Konxas8/Rocket-Motor-Test-Stand/ΒΑΣΗ ΔΟΚΙΜΗΣ ΚΙΝΗΤΗΡΩΝ ΠΥΡΑΥΛΩΝ.pdf

# ΒΑΣΗ ΔΟΚΙΜΗΣ ΚΙΝΗΤΗΡΩΝ ΠΥΡΑΥΛΩΝ

### 1. Εισαγωγή

Το παρόν κύκλωμα ειναι ενα σύστημα στατικής δοκιμής (Test Stand) για πυραυλοκινητήρες. Ο βασικός του σκοπός είναι διπλός:

1. Να πυροδοτήσειτον κινητήρα με ασφάλεια και ακρίβεια από απόσταση.
2. Να μετρήσει και να καταγράψειτηνώση (δύναμη) που παράγει ο κινητήρας σε πραγματικό χρόνο.

### 2. Ανάλυση Υποσυστημάτων

Α. Ο "Εγκέφαλος" (ESP32)

Στο κέντρο του συστήματος βρίσκεται ο μικροελεγκτής ESP32. Αυτός είναι ο υπολογιστής που συντονίζειτα πάντα. Τροφοδοτείται από μια ξεχωριστή μπαταρία LiPo (μέσω Buck Converter) για να παραμένει σταθερός και ανεπηρέαστος από τα μεγάλα ρεύματα της ανάφλεξης.

- Ρόλος: Διαβάζειτους αισθητήρες, αποθηκεύειτα δεδομένα και δίνει την εντολή πυροδότησης.

Β. Μέτρηση Δύναμης (Load Cell & HX711)

Για να μετρήσουμε πόσο δυνατά σπρώχνει ο κινητήρας, χρησιμοποιούμε ένα Load Cell. Το Load Cell μετατρέπει τη μηχανική πίεση σε ένα πολύ μικρό ηλεκτρικό σήμα.

- Επειδή αυτό το σήμα είναι ασθενές, παρεμβάλλεται ο ενισχυτής HX711, ο οποίος το μεταφράζει σε ψηφιακή μορφή ώστε να το διαβάσει το ESP32.

Γ. Σύστημα Ανάφλεξης (Ασφάλεια Δύο Σταδίων)

Για να ανάψει ο κινητήρας, χρησιμοποιούμε μια ισχυρή μπαταρία 12V (Μολύβδου). Το ρεύμα όμως δεν περνάει στον αναφλεκτήρα (Ematch) αν δεν συμφωνήσουν δύο ανεξάρτητα εξαρτήματα:

1. Το Μηχανικό Ρελέ (Relay): Λειτουργείως η "ασφάλεια οπλισμού". Ελέγχεται από ένα φυσικό κλειδί (Key Switch). Όσο το κλειδί είναι κλειστό,το κύκλωμα είναι φυσικά κομμένο. Ακόμα κι αν ο υπολογιστής κάνει λάθος, δεν μπορεί να περάσει ρεύμα. Όταν γυρίσουμε το κλειδί, το σύστημα "Οπλίζει".
2. Το MOSFET: Είναι ο ηλεκτρονικός διακόπτης ταχείας απόκρισης. Ακόμα και με το σύστημα οπλισμένο (Ρελέ κλειστό), το ρεύμα σταματάει στο MOSFET. Μόνο όταν το ESP32 δώσει ψηφιακή εντολή (μέσω λογισμικού),το MOSFET ανοίγει και επιτρέπει στο ρεύμα των 12V να φτάσει στον αναφλεκτήρα.

Δ. Έλεγχος Συνέχειας (Continuity Check)

Πριν την εκτόξευση, θέλουμε να ξέρουμε αν το καλώδιο του αναφλεκτήρα είναι συνδεδεμένο σωστά και δεν έχει κοπεί.

- Το κύκλωμα διαθέτει ένα κουμπί ελέγχου και ένα LED.
- Όταν πατάμε το κουμπί, περνάει ένα ελάχιστο, ασφαλές ρεύμα (περίπου 10mA) μέσα από τον αναφλεκτήρα.
- Αν το LED ανάψει, σημαίνει ότι το κύκλωμα είναι κλειστό και ο αναφλεκτήρας είναι έτοιμος. Το ρεύμα αυτό είναι πολύ μικρό για να προκαλέσει ανάφλεξη, αλλά αρκετό για να ανάψειτο λαμπάκι.

Ε. Καταγραφή Δεδομένων (SD Card+Wifi)

Όλα τα δεδομένα της μέτρησης (χρόνος και δύναμη) γράφονται σε μια κάρτα microSD πολλές φορές το δευτερόλεπτο. Έτσι, μετά τη δοκιμή, μπορούμε να πάρουμε την κάρτα στον υπολογιστή και να αναλύσουμε την καμπύλη ώσης του κινητήρα.

### 3. Διαδικασία Λειτουργίας

1. Εκκίνηση: Τροφοδοτούμε το ESP32. Το σύστημα κάνει αυτοδιαγνωστικό έλεγχο.
2. Τοποθέτηση: Συνδέουμε τον αναφλεκτήρα στον κινητήρα.
3. Eλεγχος: Εαν το continuity led ειναι αναμμενο σημαινει πως το mosfet μας ειναι χαλασμενο.
4. Οπλισμός: Γυρίζουμε το Κλειδί Ασφαλείας. Το Ρελέ οπλίζει. Τώρα το σύστημα περιμένει εντολή.Παταμε το continuity button και αν αναψειτο led ο αναφλεκτυρας μας ειναι συνδεδεμένος σωστά.
5. Πυροδότηση: Το ESP32 δίνει εντολή στο MOSFET. Το MOSFET ανοίγει περνάει υψηλό ρεύμα, ο κινητήρας ανάβει.
6. Καταγραφή: Ταυτόχρονα,το ESP32 καταγράφειτις τιμές από το Load Cell στην κάρτα SD μέχρι να τελειώσει η καύση.

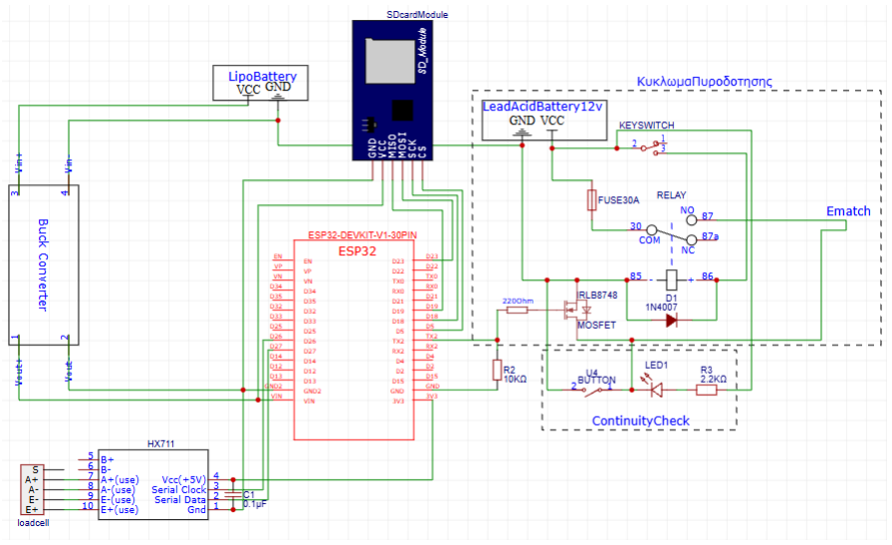
[picture p1: figure]

Λίστα υλικών
- Load cell (https://grobotronics.com/load-cell-150kg.html)
- Ενισχυτής σήματος: (https://grobotronics.com/load-cell-amplifier-hx711withoutheader.html)
- Thermistor (https://grobotronics.com/ntc-10k-thermistor-digital-temperature-probe-bolt.html)
- Esp32
- Sd_storage_board (https://grobotronics.com/breakout-board-for-micro-sd-card-mini.html)
- Μπαταρία (https://grobotronics.com/li-po-battery-7-4v-600mah-jst-rcy.html)
- Buck converter (https://grobotronics.com/dc-dc-converter-step-down-5v-1a.html)
- Electric match
- Mosfet (https://grobotronics.com/mosfet-n-channel-30v-92a-irlb8748pbf.html)
- Battery (https://grobotronics.com/lead-acid-battery-12v-4.5ah.html)
- Key switch (https://grobotronics.com/key-switch.html)
- ρελε (http://grobotronics.com/car-relay-12v-80aam3-12b.html)
- Διοδος: 1N4007
